transistormosfet/SpaceSpinning/galleria_foto/032.jpeg

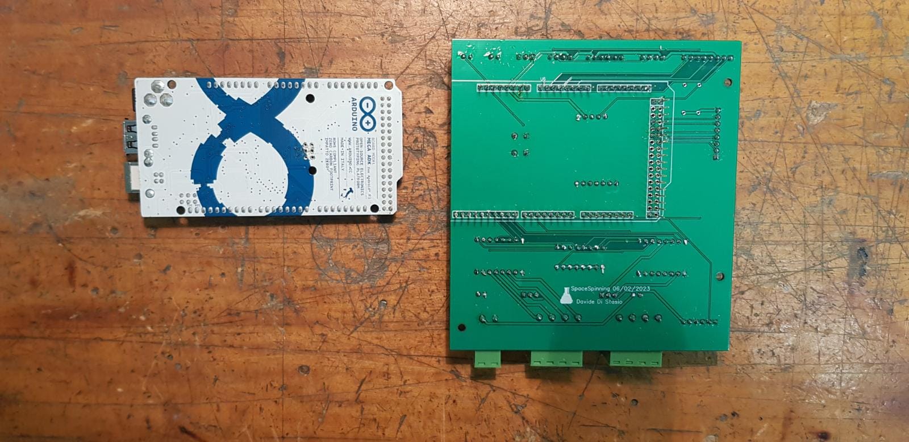
galleria_foto/032.jpeg
