transistormosfet/SpaceSpinning/galleria_foto/024.jpeg

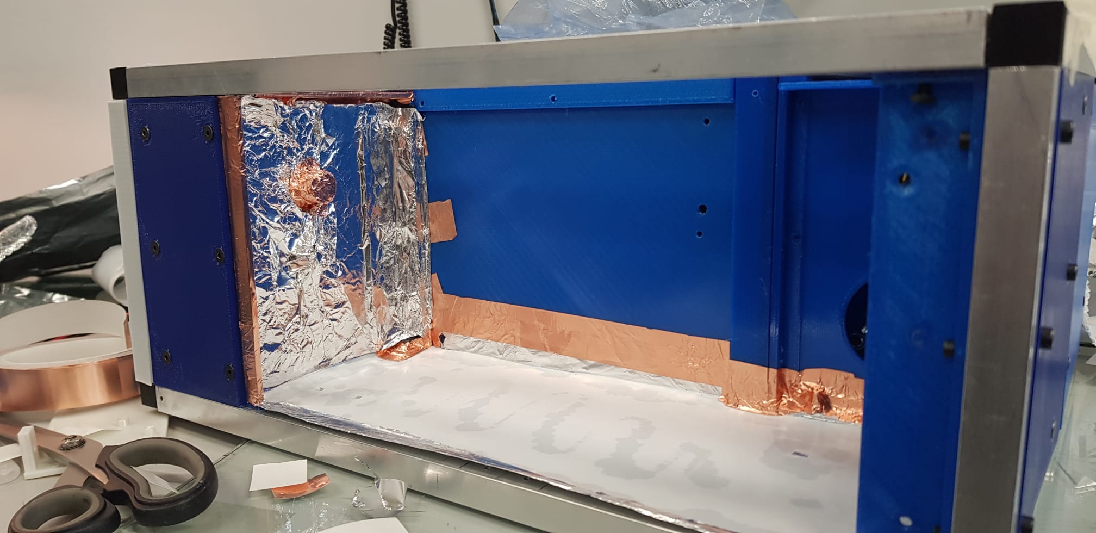
galleria_foto/024.jpeg
