transistormosfet/SpaceSpinning/README.md

# SpaceSpinning
SpaceSpinning project repository  
All Right Reserved Davide Di Stasio
