transistormosfet/SpaceSpinning/Report_e_documentazione/indirizzi_i2c_periferiche.md

0x27      lcd  
0x50 0x68 RTC  
0x40      servo  
0x60      DAC
