transistormosfet/SpaceSpinning/Report_e_documentazione/Elenco_Librerie_Arduino.md

# LIBRERIE PER SPACESPINNING 
   
LCD_I2C blackhack 2.2.0  
LiquidCrystal I2C by Frank de Brabander 1.1.2  
Adafruit Unified Sensor by Adafruit 1.1.5  
DHT sensor library by adafruit 1.4.2  
RTClib by adafruit 1.1.0  
SD by Arduino 1.2.4  
Wire by Arduino  
Servo by Arduino  
Stepper by Arduino  
AnalogRTCLib by Analog devices 1.0.0  
Adafruit_MCP4725 by Adafruit v 2.00  
Adafruit PWM Servo Driver Library by Adafruit v 2.4.1
