transistormosfet/SpaceSpinning/Report_e_documentazione/SpaceSpinning 26_10_2021.pptx

## SpaceSpinning 26/10/2021

logica Hardware Control Unit

All rights reserved. Davide Di stasio 26/10/2021

## Slide 2

S0

N prove

S10

tempo

dx

S1

N prove +-

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
tempo
+-

Hv REG

sx

sx

S8

Hv REG
+-

dx

dx

dwn

dV
+-

S30

portata

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
START

sx

S6

T=...°C
H=...%

dwn

sx

sx

S7

Hv=...kV
Q=...mL/min

dwn

dwn

N=...
t=...s

All rights reserved. Davide Di stasio 26/10/2021

## Slide 3

S0

N | | P | R | O | V | E
↓ | N | E | X | T | | | | | | | | > | S | E | T

S10

t | e | m | p | o
↓ | N | E | X | T | | | | | | | | > | S | E | T

S20

H | v | r | e | g
↓ | N | E | X | T | | | | | | | | > | S | E | T

S30

P | O | R | T | A | T | A
↓ | N | E | X | T | | | | | | | | > | S | E | T

S40

| S | T | A | R | T | | S | E | Q | U | E | N | C | E | ?
↓ | N | E | X | T | | | | | | | | > | S | E | T

S1

N | = | | #
↑ | + | | ↓ | - | | | | | | | | < | S | E | T

S2

t | = | # | # | # | # | s
↑ | + | | ↓ | - | | | | | | | | < | S | E | T

S3

H | v | = | | # | # | | k | V
↑ | + | | ↓ | - | | | > | d | V | | | < | S | E | T

All rights reserved. Davide Di stasio 26/10/2021

## Slide 4

S8

d | V | = | | # | # | | k | V
↑ | + | | ↓ | - | | | > | H | v | | | < | S | E | T

S4

Q | = | | | | | m | L | / | h
↑ | + | | ↓ | - | | | > | d | Q | | | < | S | E | T

S9

d | Q | = | | | | m | L | / | h
↑ | + | | ↓ | - | | | > | Q | | | | < | S | E | T

S5

T | = | | # | # | | ° | C | | H | = | | # | # | | %
< | S | T | O | P | | | | | | | N | E | X | T | ↓

S6

H | v | = | # | # | | k | V | | Q | = | # | # | #
< | S | T | O | P | | | | | | | N | E | X | T | ↓

S7

N | = | | # | | | | | t | = | # | # | # | # | | s
< | S | T | O | P | | | | | | | N | E | X | T | ↓

All rights reserved. Davide Di stasio 26/10/2021
