transistormosfet/SpaceSpinning/galleria_foto/001.jpeg

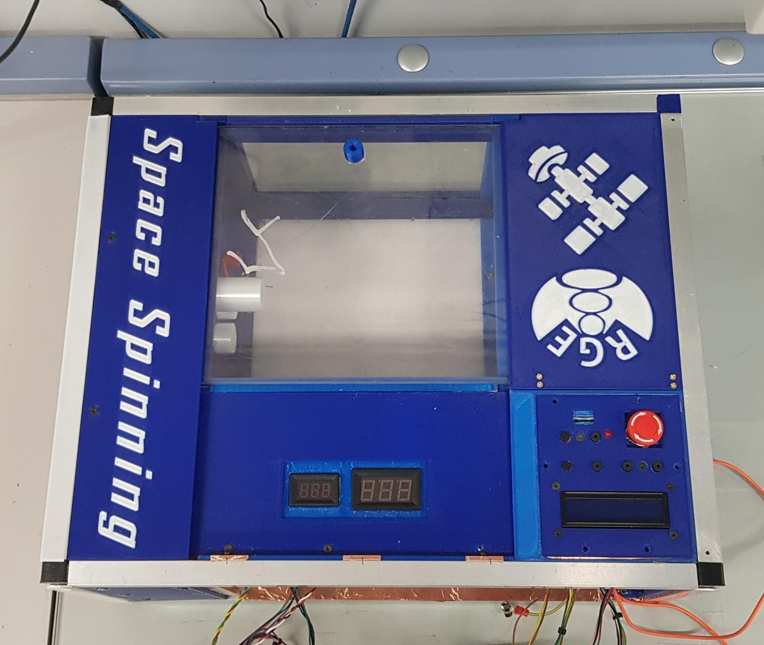
galleria_foto/001.jpeg
