transistormosfet/SpaceSpinning/galleria_foto/003.jpeg

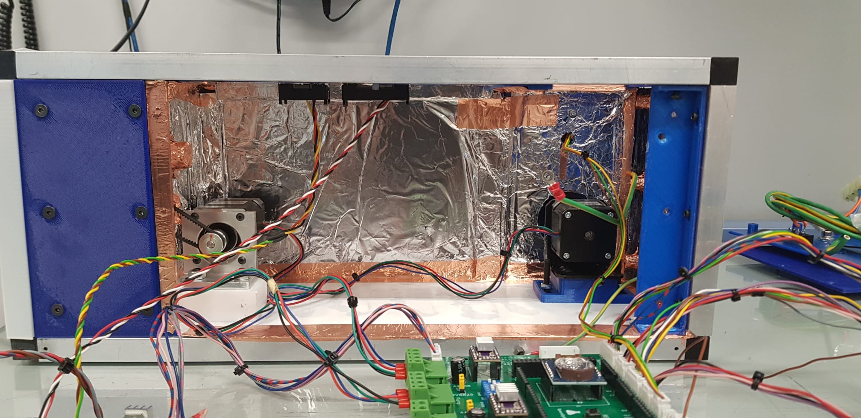
galleria_foto/003.jpeg
