transistormosfet/SpaceSpinning/galleria_foto/004.jpeg

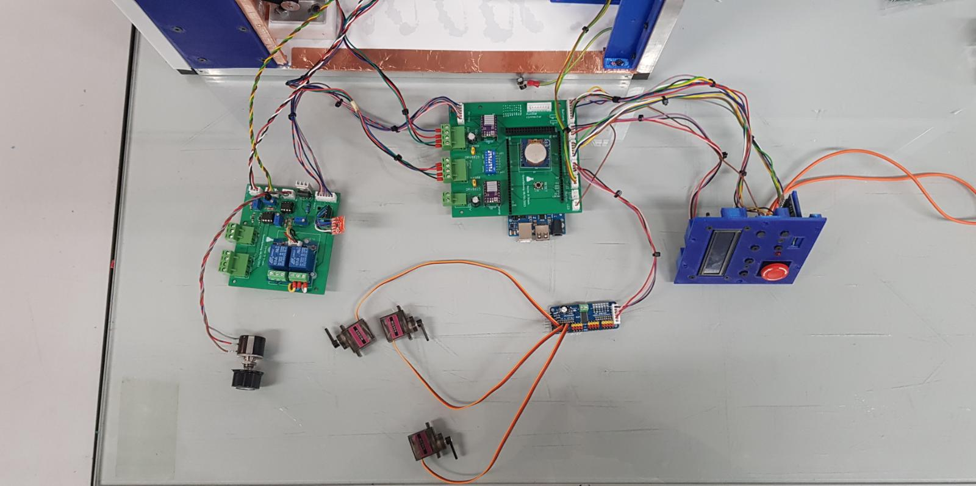
galleria_foto/004.jpeg
