transistormosfet/SpaceSpinning/galleria_foto/006.jpeg

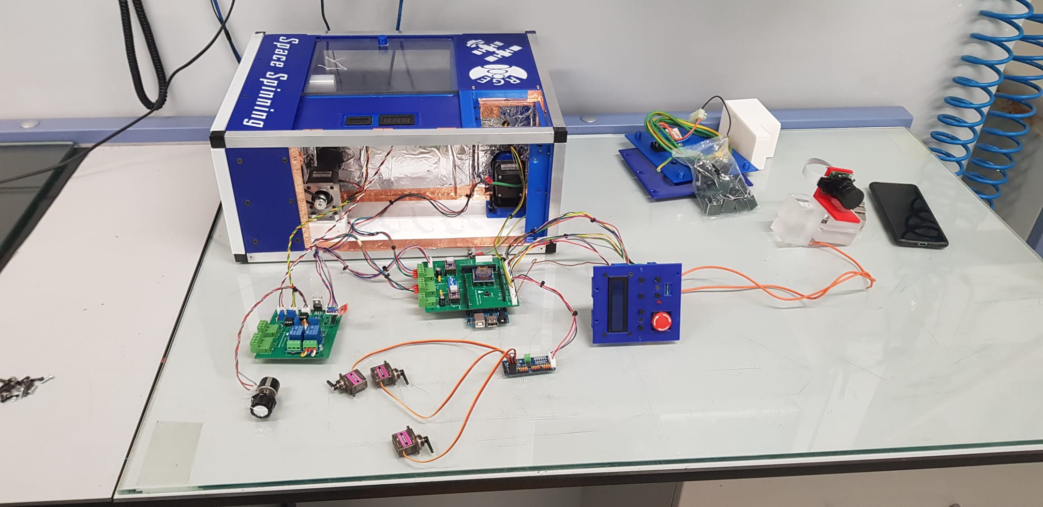
galleria_foto/006.jpeg
