transistormosfet/SpaceSpinning/galleria_foto/009.jpeg

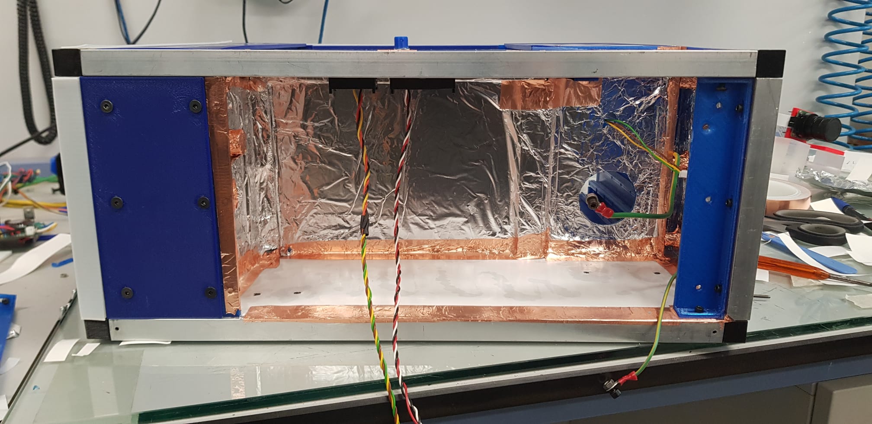
galleria_foto/009.jpeg
