transistormosfet/SpaceSpinning/galleria_foto/010.jpeg

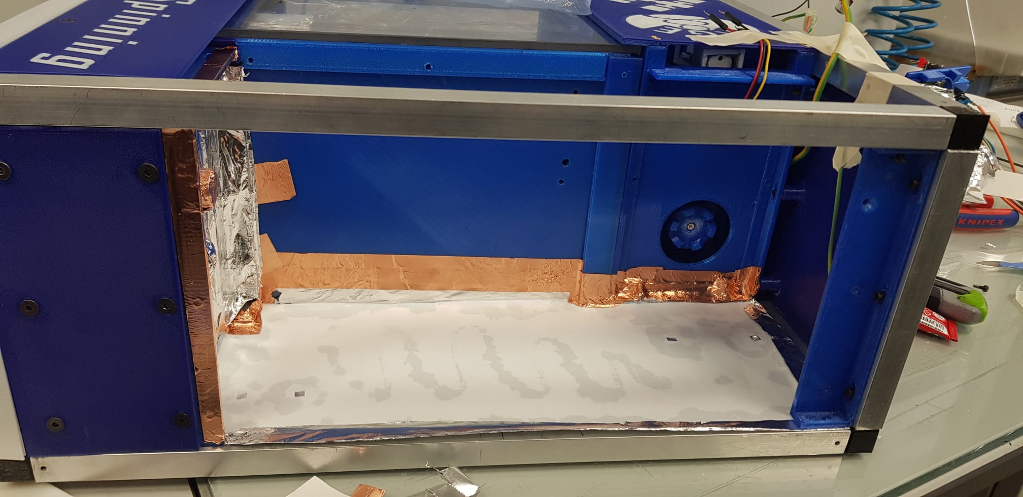
galleria_foto/010.jpeg
