transistormosfet/SpaceSpinning/galleria_foto/014.jpeg

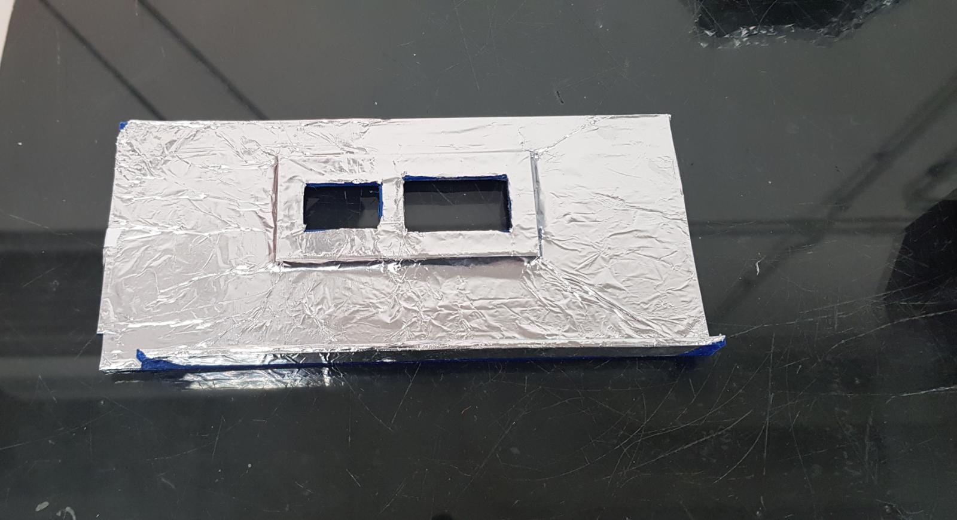
galleria_foto/014.jpeg
