transistormosfet/SpaceSpinning/galleria_foto/016.jpeg

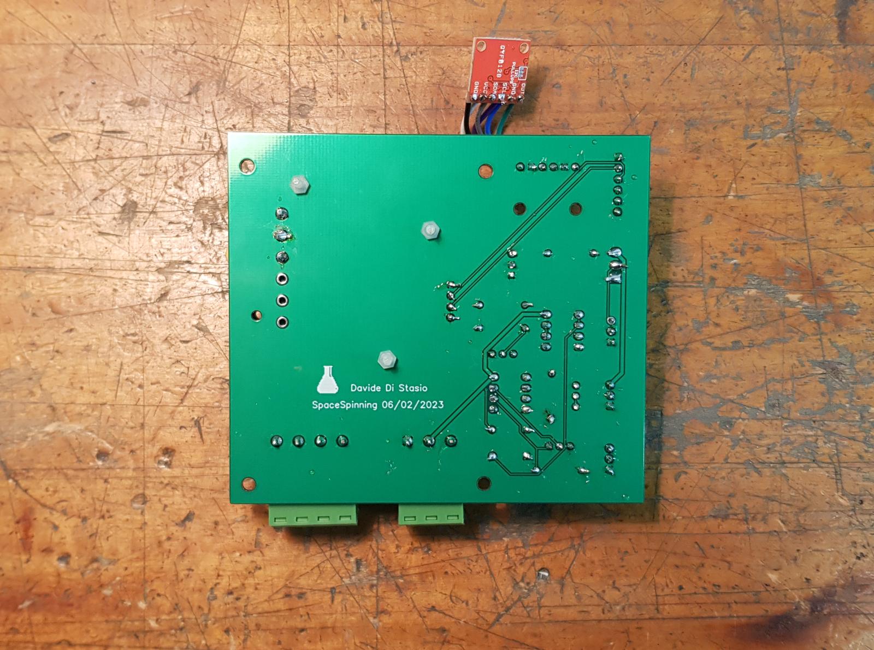
galleria_foto/016.jpeg
