transistormosfet/SpaceSpinning/galleria_foto/018.jpeg

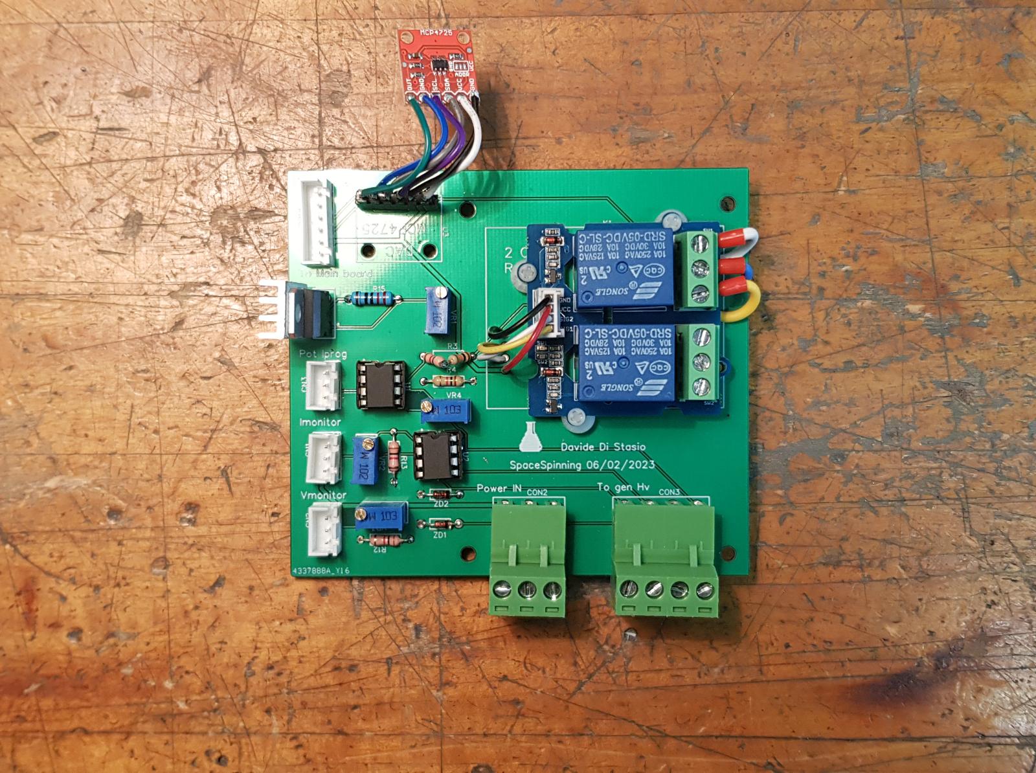
galleria_foto/018.jpeg
