transistormosfet/SpaceSpinning/galleria_foto/020.jpeg

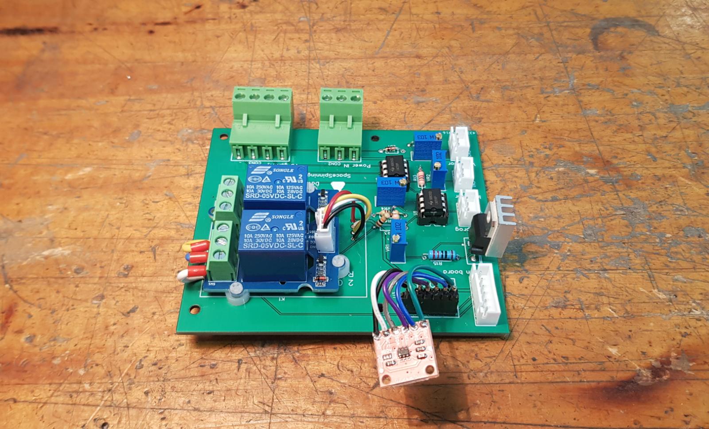
galleria_foto/020.jpeg
