transistormosfet/SpaceSpinning/galleria_foto/022.jpeg

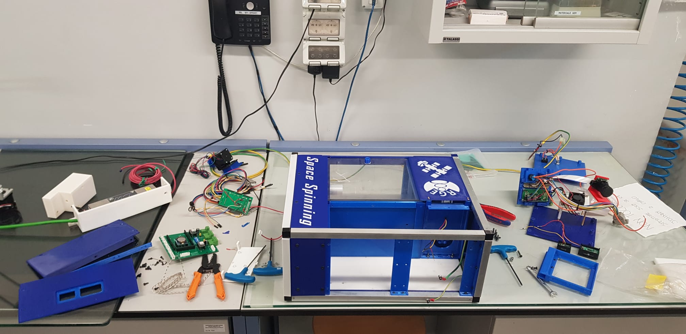
galleria_foto/022.jpeg
