transistormosfet/SpaceSpinning/galleria_foto/026.jpeg

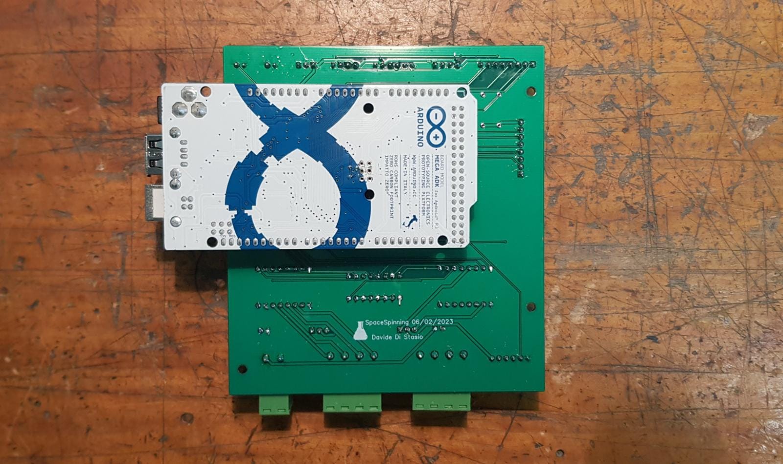
galleria_foto/026.jpeg
