transistormosfet/SpaceSpinning/galleria_foto/028.jpeg

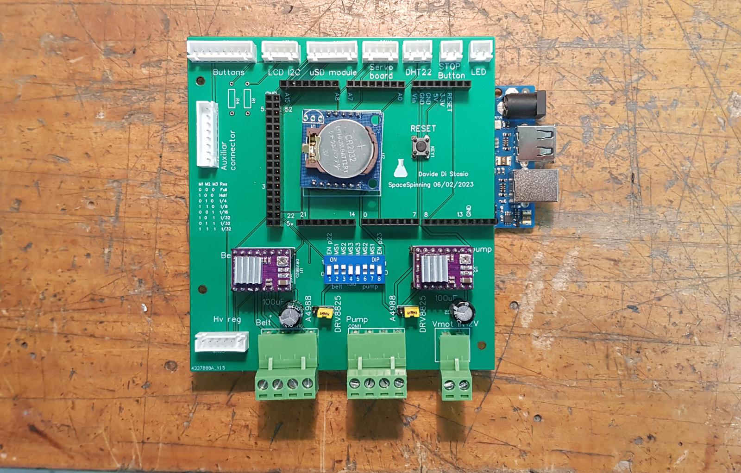
galleria_foto/028.jpeg
