transistormosfet/SpaceSpinning/galleria_foto/030.jpeg

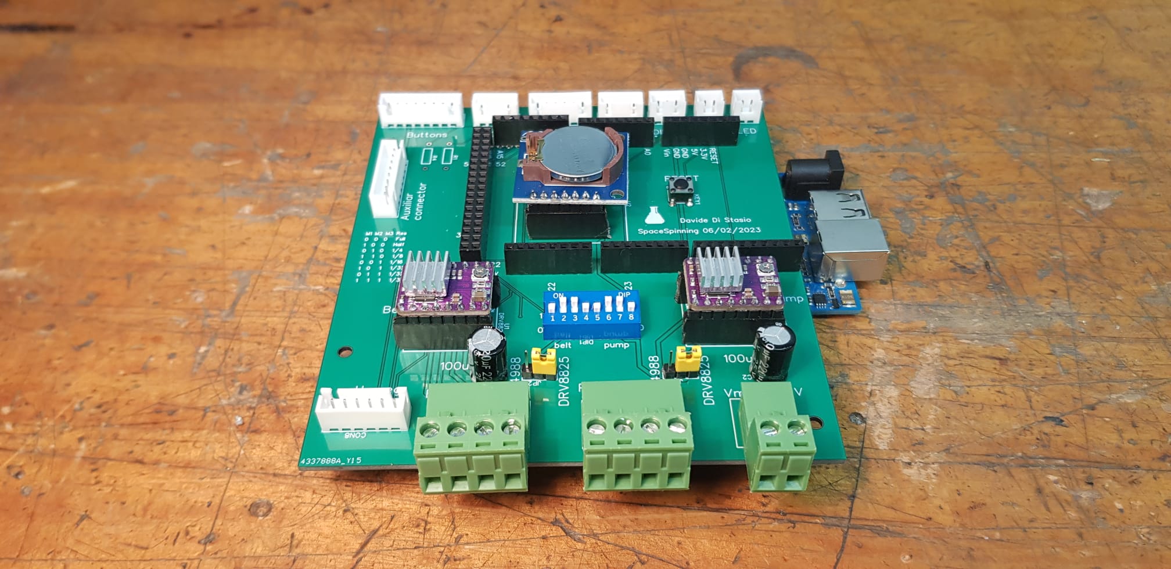
galleria_foto/030.jpeg
