transistormosfet/SpaceSpinning/galleria_foto/033.jpeg

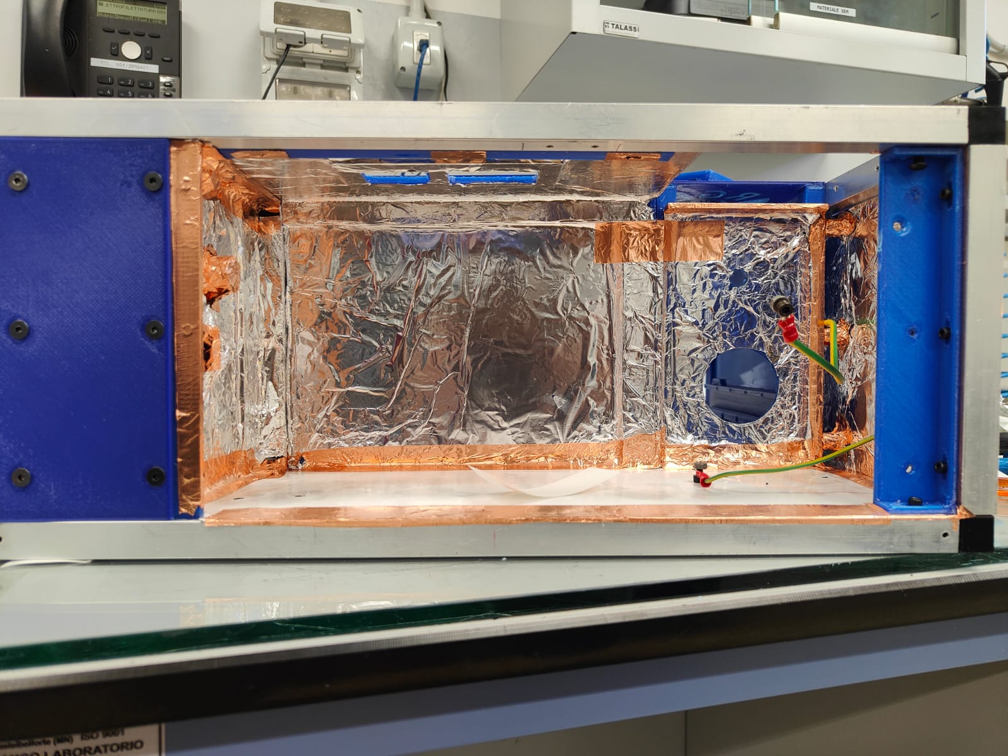
galleria_foto/033.jpeg
