transistormosfet/SpaceSpinning/galleria_foto/034.jpeg

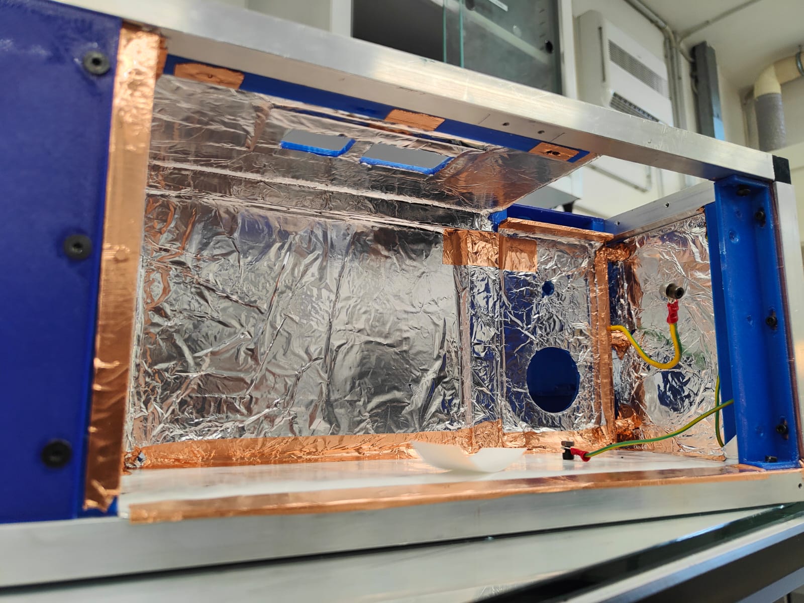
galleria_foto/034.jpeg
