transistormosfet/SpaceSpinning/galleria_foto/036.jpeg

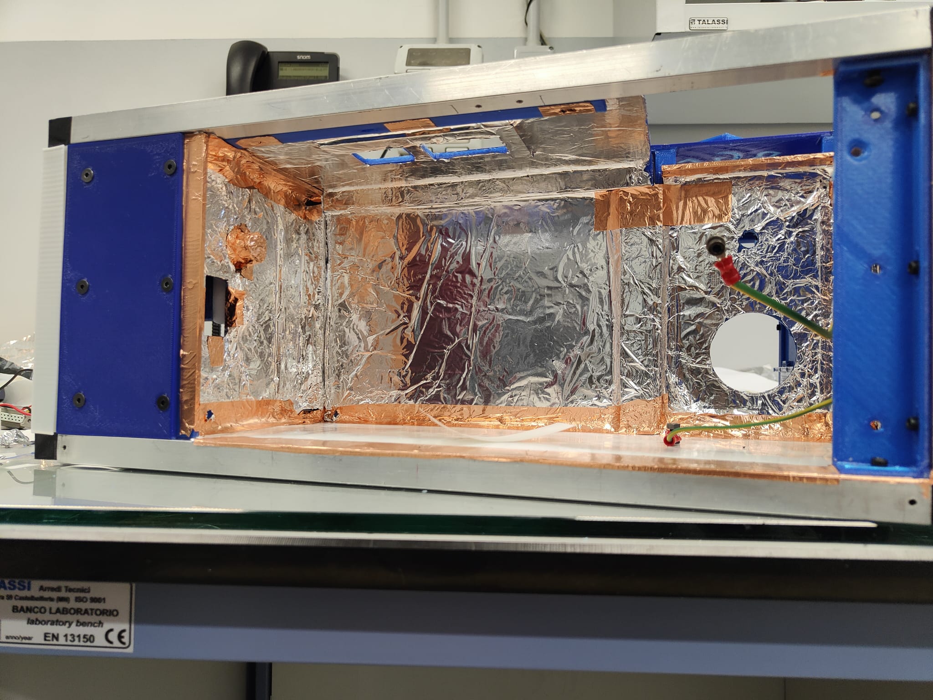
galleria_foto/036.jpeg
