transistormosfet/SpaceSpinning/galleria_foto/038.jpeg

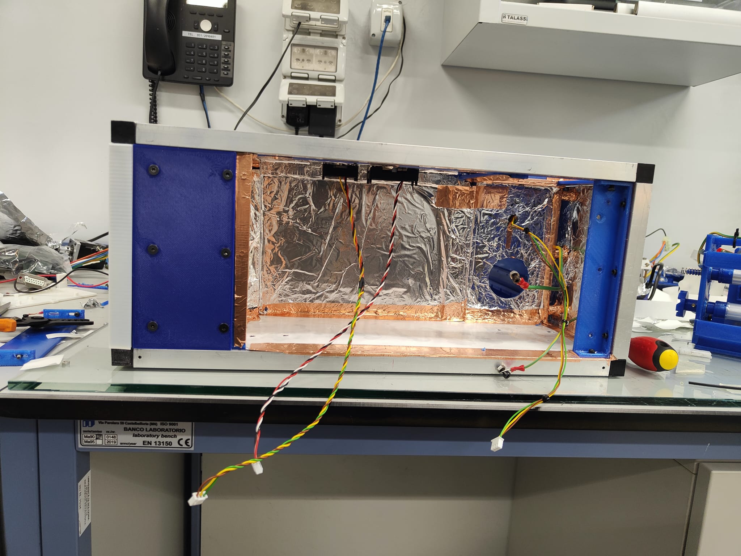
galleria_foto/038.jpeg
