transistormosfet/SpaceSpinning/galleria_foto/040.jpeg

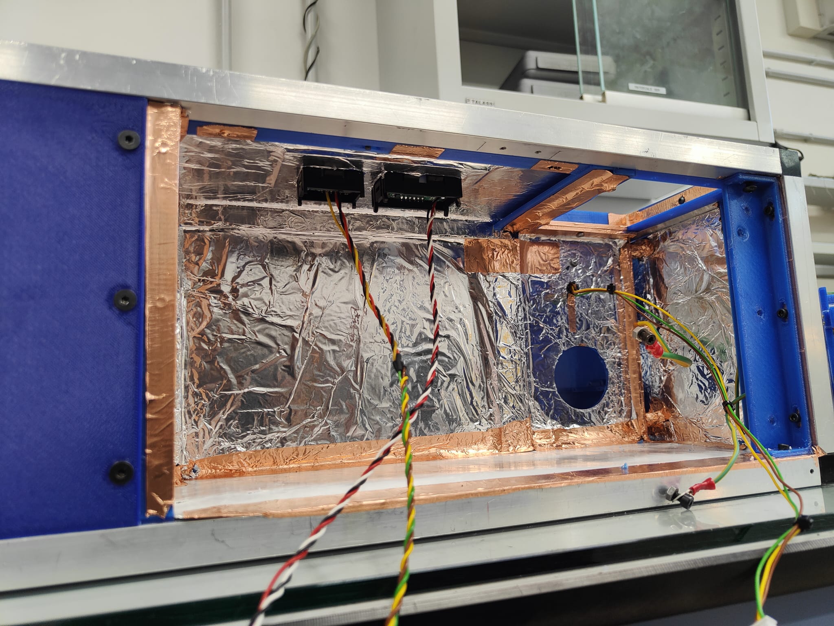
galleria_foto/040.jpeg
