transistormosfet/SpaceSpinning/galleria_foto/043.jpeg

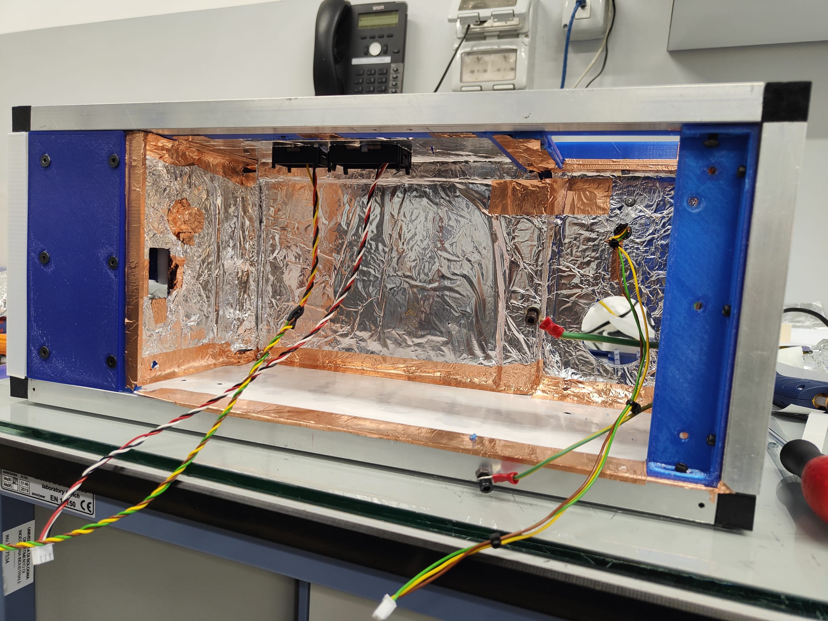
galleria_foto/043.jpeg
