transistormosfet/SpaceSpinning/galleria_foto/044.jpeg

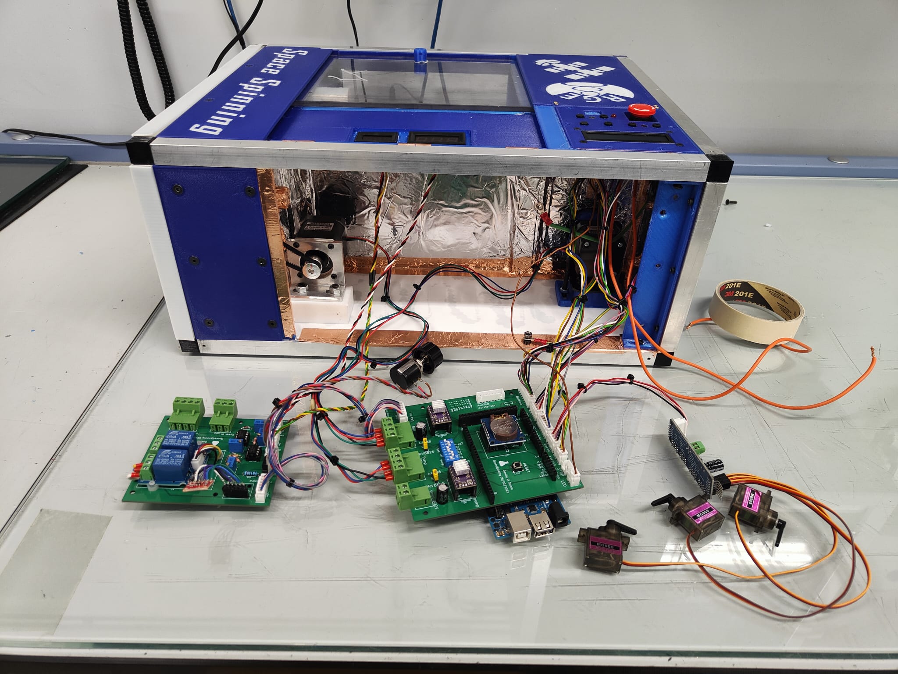
galleria_foto/044.jpeg
