transistormosfet/SpaceSpinning/galleria_foto/047.jpeg

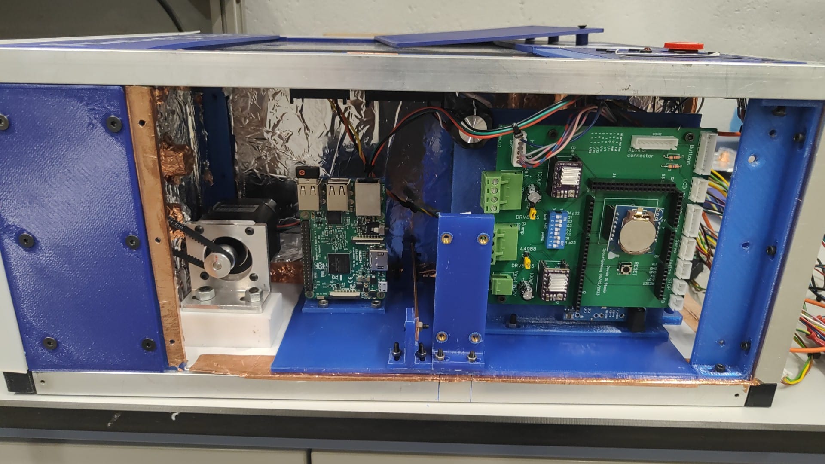
galleria_foto/047.jpeg
