transistormosfet/SpaceSpinning/schemi_elettrici_e_pcb/pcb 3d.jpeg

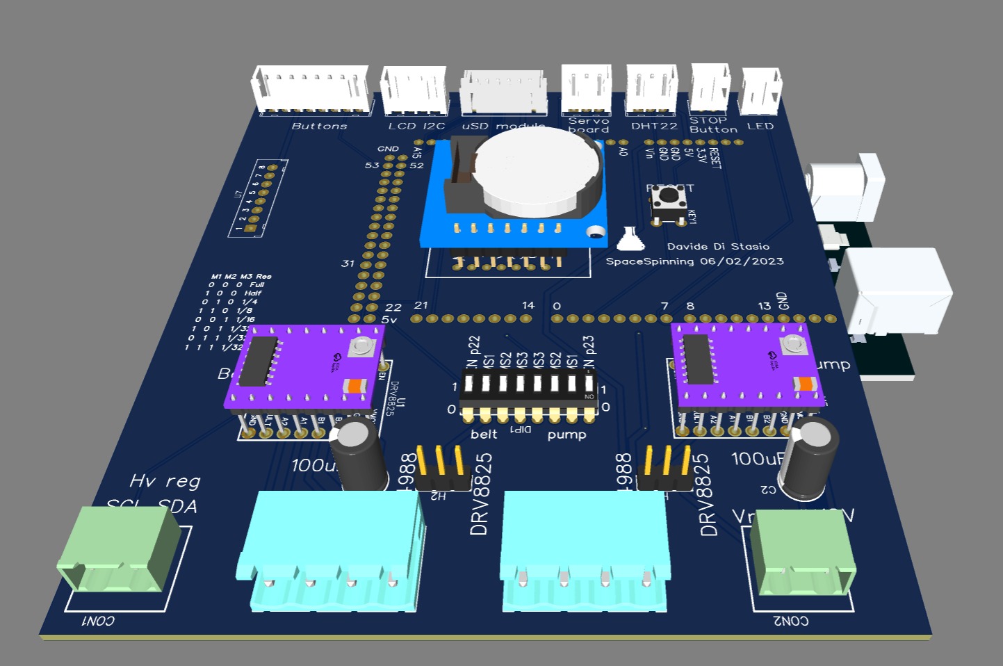
schemi_elettrici_e_pcb/pcb 3d.jpeg
