transistormosfet/SpaceSpinning/schemi_elettrici_e_pcb/pcb_analog_controls_2d.png

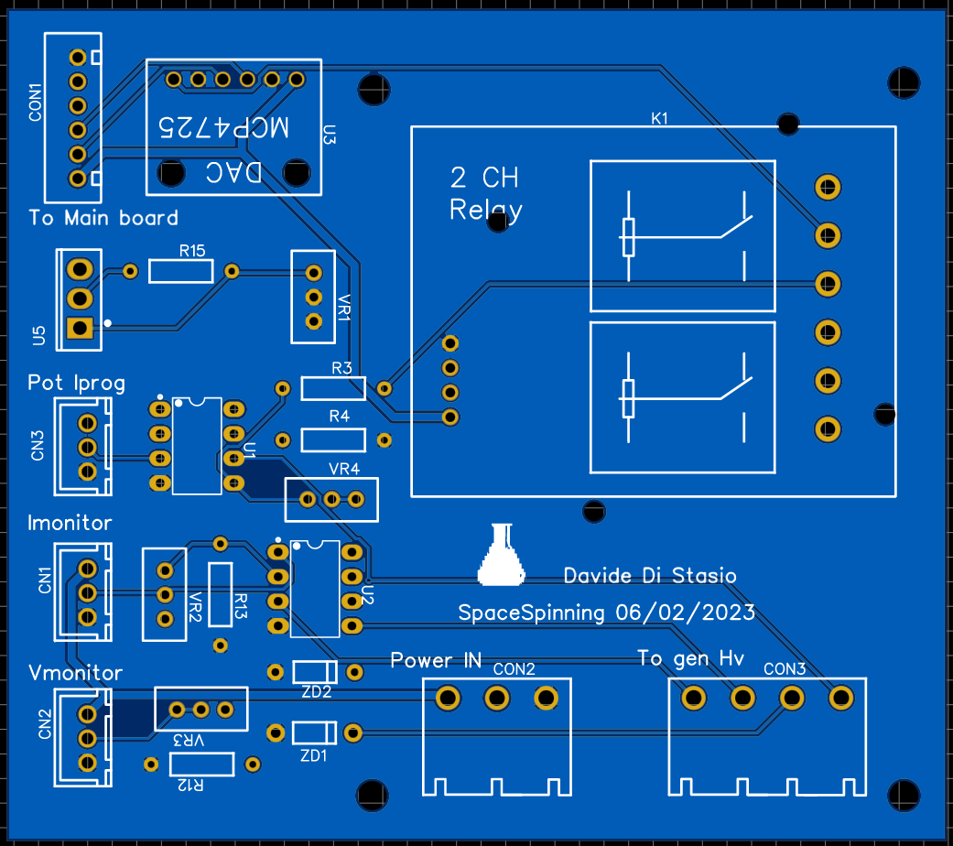
schemi_elettrici_e_pcb/pcb_analog_controls_2d.png
