transistormosfet/SpaceSpinning/schemi_elettrici_e_pcb/pcb_main_board_3d.png

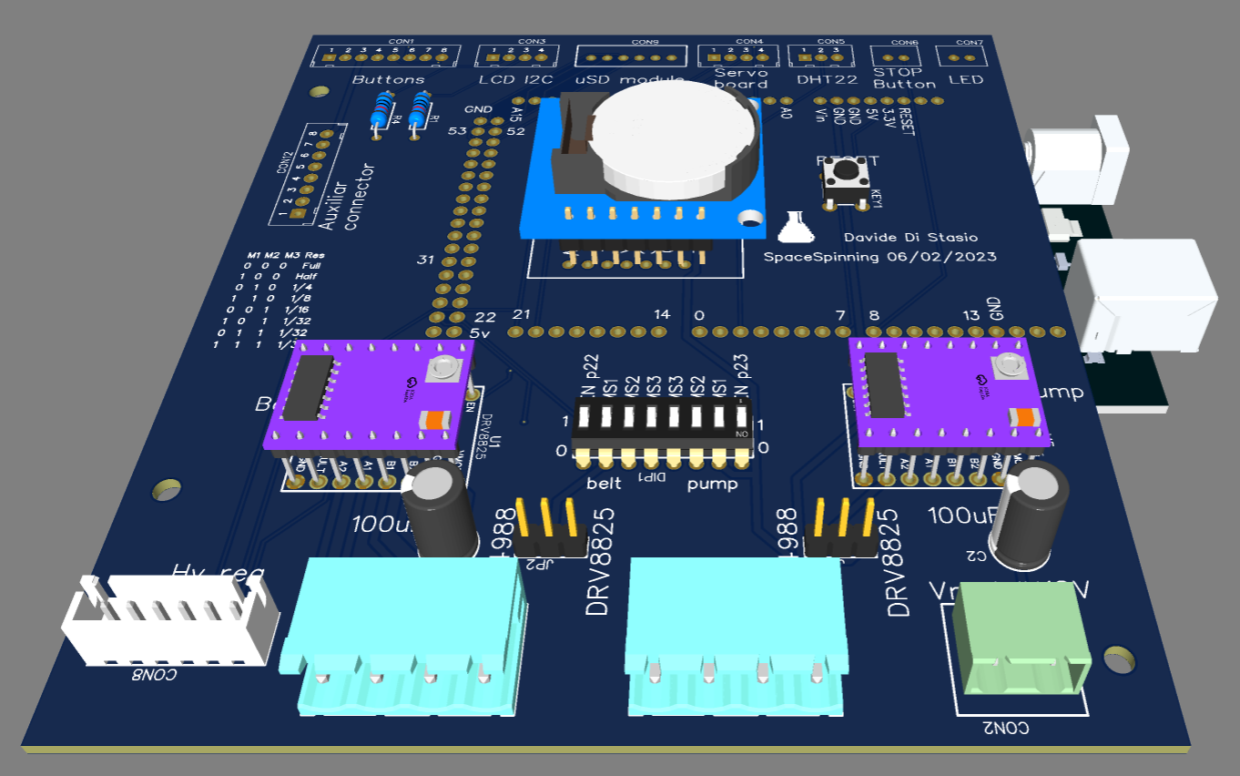
schemi_elettrici_e_pcb/pcb_main_board_3d.png
