transistormosfet/SpaceSpinning/schemi_elettrici_e_pcb/schema elettrico analog controls.png

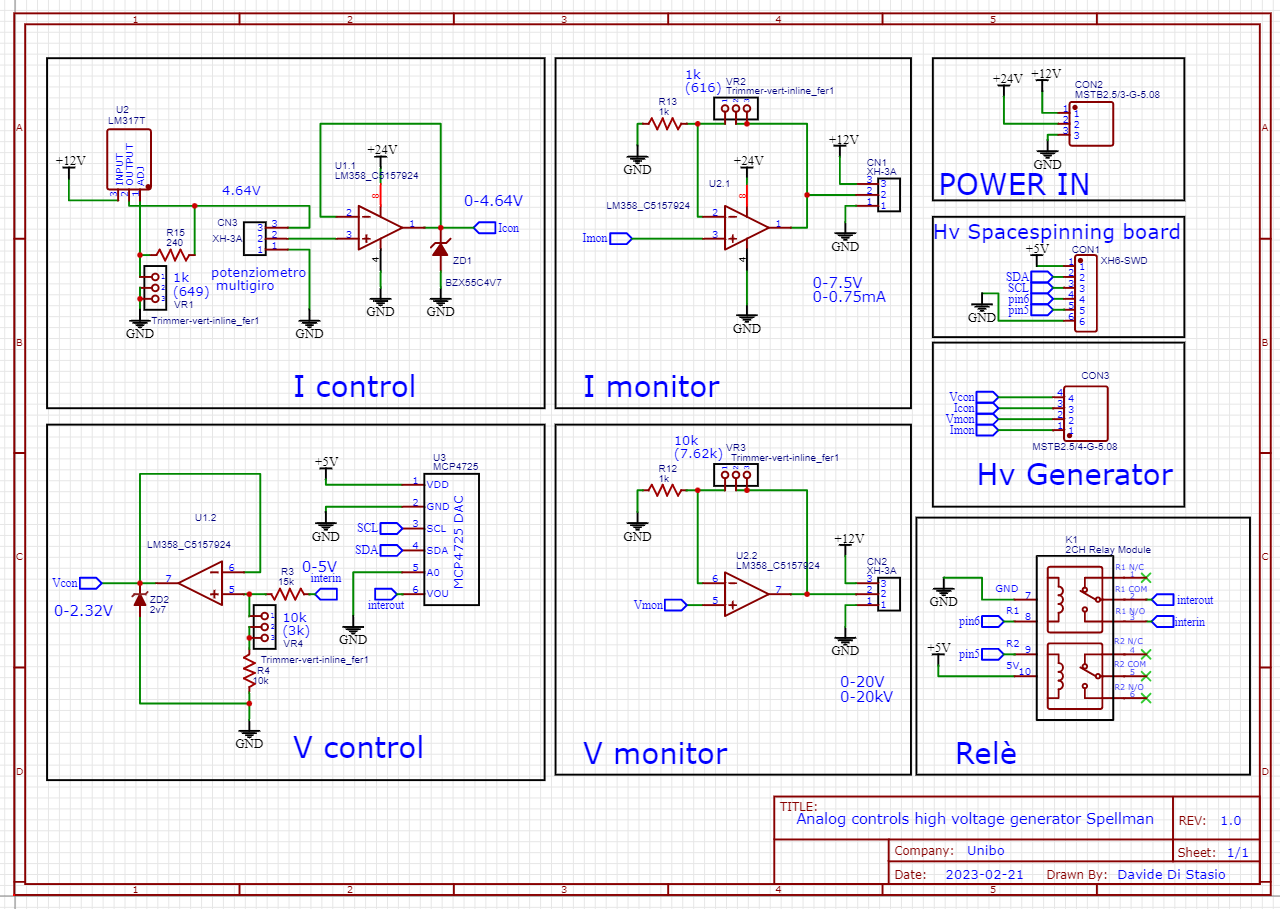
schemi_elettrici_e_pcb/schema elettrico analog controls.png
