transistormosfet/SpaceSpinning/schemi_elettrici_e_pcb/schema elettrico main board.png

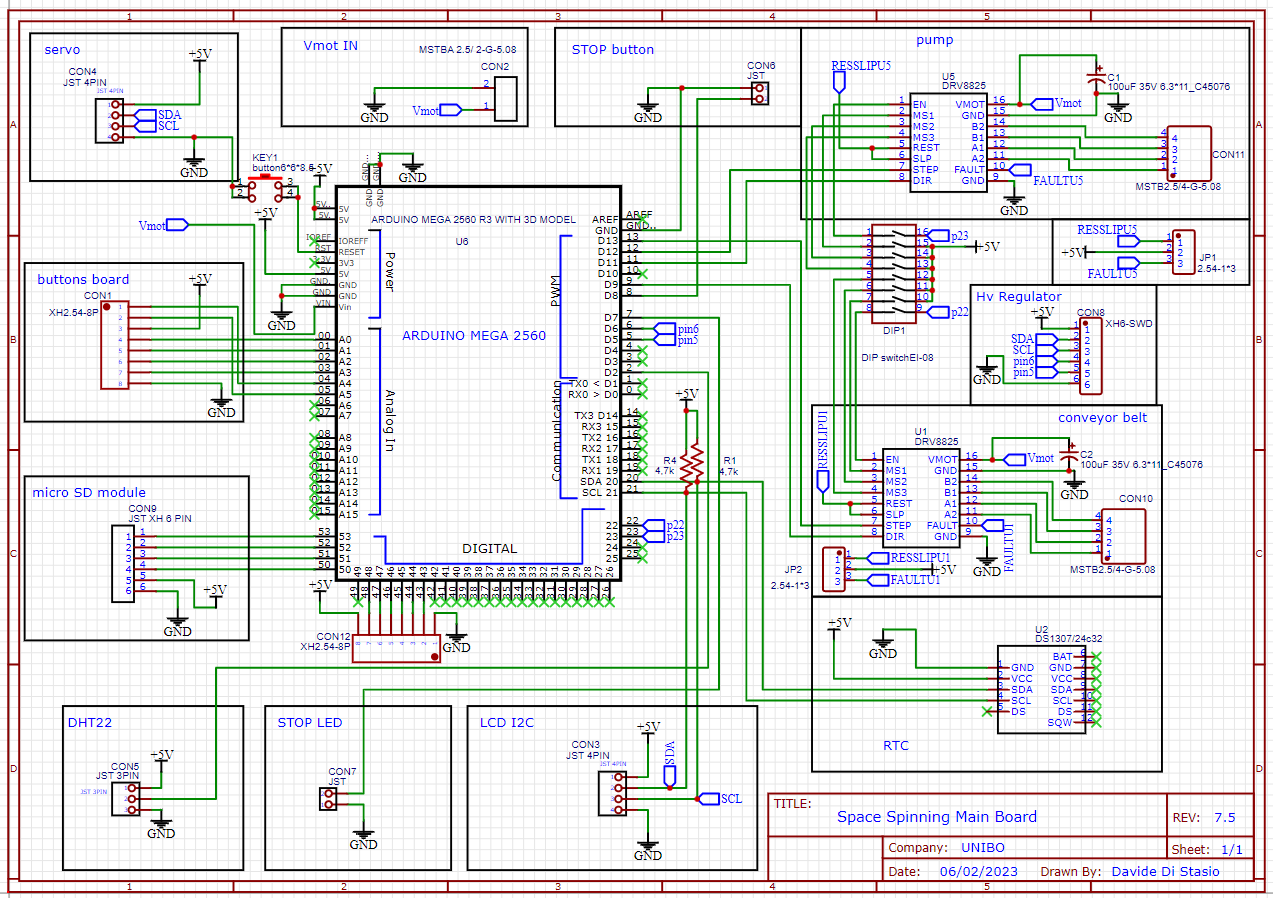
schemi_elettrici_e_pcb/schema elettrico main board.png
