transistormosfet/SpaceSpinning/(commit log)

2023-03-06 upload servo sda scl and new spwllman circuit
2023-03-07 aggiunta file md di appunti modifiche hw-sw
2023-03-07 aggiunto powerpoint menù LCD
2023-03-14 in 7.8 corretto spegnimento del gen Hv durante le fasi di pausa elettrofilatura
2023-03-20 cambiato senso di rotazione del motore nastro
2023-03-20 aggiunta relè a monte del dac sul pin 10
2023-03-20 ricorretto il pilotaggio relè e il voltage max
2023-03-21 stesura report costruzione circuito controllo gen Hv
2023-03-21 risolti movimenti servo con scheda esterna, da modificare ancora SERVOMAX e SERVOMIN
2023-03-21 aggiornamento schemi elettrici e PCB
2023-04-06 stesura report costruzione main board e analog controls_05_04_23
2023-04-06 stesura Report costruzione main board e analog control_05_04_23
2023-04-07 completamento report costruzione main board e analog controls Spelmann_05_04_23
2023-04-13 cambiato pin del nastrto trasportatore
2023-04-17 pwm riposo spostati dopo la dichiarazione del pwm e aggiunto il documento indirizzi i2c periferiche
2023-05-13 aggiunta report progettazione power unit
